Sharif-University-ESRLab/project-team-5/Code/ReadMe

This folder should contain the source code of your project.
