Sharif-University-ESRLab/project-team-5/Document/Final Report/latex/reportWeek3.tex

\documentclass[12pt,a4paper]{article}
\newcommand\persiangloss[2]{#1\dotfill\lr{#2}\\}
\usepackage{graphicx}
\usepackage{xcolor}
\usepackage{listings}
\usepackage{indentfirst}
\usepackage{float}
\usepackage[pagebackref=false,colorlinks,linkcolor=blue,citecolor=magenta]{hyperref}
\usepackage{xepersian}
\settextfont{XB Niloofar}
\definecolor{vgreen}{RGB}{104,180,104}
\definecolor{vblue}{RGB}{49,49,255}
\definecolor{vorange}{RGB}{255,143,102}

\lstdefinestyle{verilog-style}
{
	language=C,
	basicstyle=\small\ttfamily,
	keywordstyle=\color{vblue},
	identifierstyle=\color{black},
	commentstyle=\color{vgreen},
	numbers=left,
	numberstyle=\tiny\color{black},
	numbersep=10pt,
	tabsize=8,
	moredelim=*[s][\colorIndex]{[}{]},
	literate=*{:}{:}1
} 

\begin{document}
	\thispagestyle{empty}
	\vspace*{0mm}
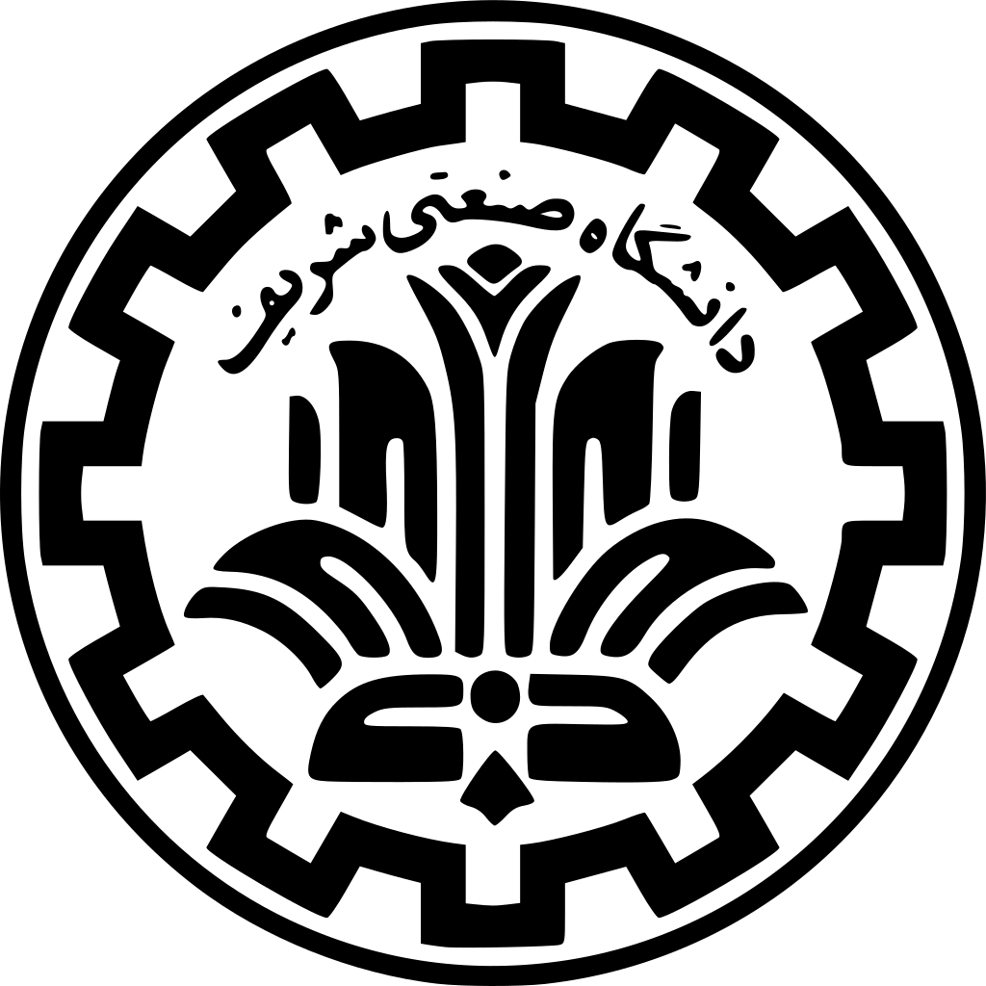
[picture p1: Document/Final Report/latex/logo.png]
	\centerline{}
	\vspace*{5mm}
	\begin{center}
		{\Huge
			لوستر هوشمند
		}
		\\[1cm]
		آزمایشگاه سخت‌افزار
		\\[1cm]
		دانشکده مهندسی کامپیوتر
		\\[4cm]
		{\large
			محمدرضا عبدی ۹۷۱۱۰۲۸۵
			
			حمیدرضا کامکاری ۹۷۱۱۰۱۷۷
			
			یگانه قره‌داغی 97106216
		}
		\\[5cm]
		خرداد ۱۴۰۱
	\end{center}
	\newpage
		\section*{چکیده}
	
	روند خودکار سازی فعلی خانه‌ها قدمی مهم برای کاهش مصرف بی‌اندازه برق و تسهیل زندگی افراد خانه است. انواع لوستر‌ها و تجهیزات روشنایی از جدیدترین وسایل اضافه شده به لوازم خانگی هوشمند هستند. هدف از این پروژه طراحی یک لوستر هوشمند است که بتواند به کمک یک برنامه به لوازم جانبی هوشمند دیگر (مانند تلفن‌های همراه) متصل شود و توسط آن به صورت خودکار یا دستی تنظیم شود. این دستگاه جزو یک شبکه اینترنت اشیا (\lr{Internet of Things}) است و با استفاده از یک برنامه موبایل قابل مدیریت است. 
	
	در این گزارش به توضیح قابلیت‌ها، محدودیت‌ها، قطعات و جزئیات پیاده‌سازی لوستر هوشمند در ۶ بخش می‌پردازیم.
	\newpage
	
	\tableofcontents
	
		\newpage
	
	\section{قابلیت‌های لوستر هوشمند}
	با توجه به اهداف پروژه در خودکار سازی روشنایی خانه\footnote{کاهش مصرف برق و تسهیل استفاده نسبت به لوسترهای مرسوم}، قابلیت‌های زیر برای محصول در نظر گرفته شده‌اند\footnote{جزئیات قابلیت‌ها در توصیف برنامه موبایل به صورت کامل توضیح داده‌ می‌شود.}:
	
	\begin{itemize}
		\item
		در اولین مرحله این لوستر می‌تواند به کمک سنسوری بر اساس شرایط محیطی مانند وضعیت پرده‌ها یا روشنایی طبیعی بازخورد بدهد؛ در صورت زیاد بودن شدت نور محیط، روشنایی لوستر کاهش و در صورت کم بودن شدت نور افزایش می‌یابد. میزان حساسیت نسبت به روشنایی و میزان روشنایی مورد نیاز می‌تواند بر اساس نیاز کاربر تغییر کند. به عنوان مثال پارامتر‌ اندازه اتاق می‌تواند در تنظیمات تاثیر داده شود. یعنی برای اتاق‌های بزرگتر شدت نور به هنگام روشن بودن بیشتر باشد. 
		\item
		می‌توان تنظیمات روشنایی لوستر را به صورت خودکار یا دستی تنظیم کرد. در صورت انتخاب حالت دستی، کاربر می‌تواند میزان روشنایی ثابتی را انتخاب کند.
		\item
		کاربر می‌تواند شاخه (اتاق‌های مختلف خانه) دلخواه خود را انتخاب کند و تنظیمات هر کدام از قسمت‌ها را به صورت جداگانه انجام دهد.
		\item
		کاربر می‌تواند از میان حالت‌های‌ \footnote{Mode} مختلف ارائه شده برای زیبایی یا رقص نور استفاده نماید.
		\item
		تمامی تنظیمات مذکور می‌توانند توسط یه برنامه موبایل سازگار با دستگاه‌های مبتنی بر سیستم‌عامل‌های مختلف همانند \lr{Andriod} و \lr{IOS} در لوستر اعمال شوند.
	\end{itemize}
	\newpage
	\section{محدودیت‌های اولیه لوستر هوشمند}
	
	در هنگام پیاده‌سازی و استفاده از پروژه با محدودیت‌هایی مواجه می‌شویم که در ادامه آن‌ها را تشریح می‌کنیم:
	
	\begin{itemize}
		\item
		چالش اصلی اتصال تعداد زیادی دیود ساطع نور \lr{LED\footnote{\lr{Light-emitting diode}}} با نورهای متغیر به برد برای شبیه‌سازی یک لوستر واقعی است. در نهایت با اتصال ۴۰ قطعه \lr{LED} به یک منبع خارجی ۵ ولت و کنترل آن بویسله خروجی \lr{PWM} و دو ترانزیستور (برای دو شاخه - کد این پروژه قابلیت پشتیانی از تعداد شاخه‌های بیشتر را نیز دارد) لوستر را شبیه‌سازی کردیم.
		\item
		در برخی موارد، برنامه‌های گوشی‌های هوشمند با اتصال خود به سیستم روشنایی سازگار نیستند. در این پروژه سعی شده‌است که یک برنامه موبایل سازگار با سیستم‌عامل‌های مانند \lr{Android}و \lr{IOS} مختلف برای برطرف شدن این مشکل ارائه شود.
		\item
		با وجود اینکه این موضوع کمتر و کمتر اتفاق می‌افتد، اما هر اتصال \lr{WiFi}‌ای گاهی اوقات دچار اختلال می‌شود. با توجه به اینکه لوستر هوشمند بستری بر پایه \lr{IoT} است، بدون اتصال \lr{WiFi} نمی‌توان از تنظیمات لوستر بهره برد. بنابراین پیشنهاد می‌شود که دکمه‌ها و یا کلید‌های سخت‌افزاری همچنان برای تنظیمات پایه‌ موجود باشد.
	\end{itemize}
	\newpage
	\section{قطعات مورد استفاده}
	لوستر از دو شاخه \lr{LED} تشکیل شده و میزان ولتاژ ورودی هر کدام از این شاخه‌ها از طریق پورت مربوطه روی بورد \lr{Arduino} و ترانزیستور (\lr{MOSFET IRF640}) کنترل می‌شود. برای پیاده‌سازی منطق لوستر از بورد \lr{Arduino Mega} استفاده می‌کنیم که از طریق سنسور‌های تشخیص نور (\lr{BH1750FVI}) نور محیط را تشخیص می‌دهد و بر اساس پیش‌فرض‌هاییکه در سرور \lr{IOT} چیده‌شده میزان ولتاژ خروجی‌های آنالوگ را تنظیم می‌کند. از طرفی برای اتصال به اینترنت اشیا یک سرور کوچک خانگی را روی ماژول \lr{ESP8266 ESP-01S} اجرا می‌کنیم. این سرور تنظیمات کنترل لوستر را در خود دارد و با استفاده از گوشی همراه و اتصال به آن سرور می‌توانیم این تنظیمات را کنترل کنیم. می‌توان در این پروژه از برد \lr{Arduino Uno} نیز استفاده کرد.
	
	در جدول زیر می‌توان هزینه برآورد شده قطعات و هزینه‌های پروژه را مشاهده کرد (هزینه کل معادل با 7,580,000 ریال است).
	
	\begin{table}[H]
		\centering
		\begin{tabular}{|c|c|c|}
			\hline
			هزینه     & تعداد & نام قطعه                                    \\ \hline
			700,000   & ۱     & ماژول سنجش شدت نور GY-30 با سنسور BH1750FVI \\ \hline
			۴۵۰,۰۰۰   & ۱     & ماژول ESP8266وای فای                        \\ \hline
			4,500,000 & 1     & آردوینو مگا 2560 R3                         \\ \hline
			200,000   & 1     & کابل USB به USB Type-B مخصوص آردوینو        \\ \hline
			240,000   & ۴۰    & اورل LED در دو رنگ اصلی                     \\ \hline
			70,000    & ۱     & کابل 30 سانتی نر به ماده (1  بسته 40 عددی)  \\ \hline
			700,000   & ۲     & کابل جامپر مخصوص برد بورد (بسته ۶۰ عددی)    \\ \hline
			700,000   & ۲     & برد بورد مدل MB-102 بدون ماژول تغذیه        \\ \hline
			20,000    & ۱۰    & مقاومت                                      \\ \hline
		\end{tabular}
		\caption{برآورد هزینه قطعات}
	\end{table}
	
	لیست قطعات و شرح پین‌های آن‌ها به شرح زیر است:
	\begin{enumerate}
		\item {
			سنسور روشنایی : \lr{BH1750FVI}
			\footnote{	ما مقادیر \lr{lux} را از \lr{BH1750} از طریق باس \lr{I2C} دریافت می کنیم. \lr{ADC} در \lr{IC} روشنایی آنالوگ را به مقدار لوکس دیجیتال تبدیل می‌کند. سپس این داده‌ها با کمک پین‌های \lr{I2C} یعنی \lr{SCL} و \lr{SDA} به میکروکنترلر منتقل می‌شوند. \lr{SCL} برای ارائه پالس ساعت و \lr{SDA} برای انتقال مقدار \lr{lux} استفاده می‌شود.}}
		
		\begin{figure}[H]
			\centering
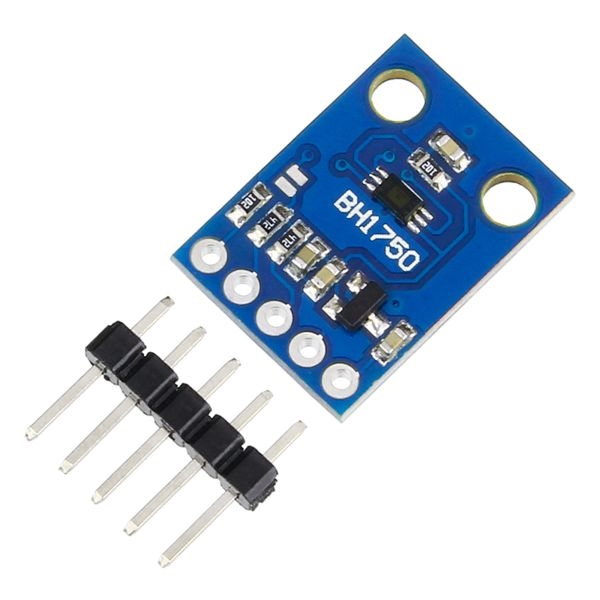
[picture p2: Document/Final Report/latex/figs/BH1750FVI.jpeg]
			
			\caption{
				سنسور روشنایی \lr{BH1750FVI}
			}
			\label{fig:schema1}
		\end{figure}
		
		\begin{figure}[H]
			\centering
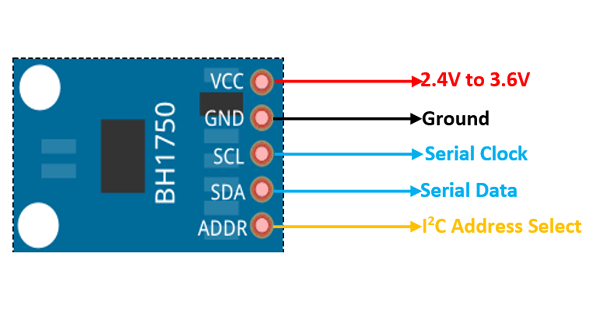
[picture p3: Document/Final Report/latex/figs/BH1750-Light-Sensor-Pinout.png]
			
			\caption{
				شرح پین‌های \lr{BH1750FVI}
			}
			\label{fig:schema2}
		\end{figure}
		
		\begin{figure}[H]
			\centering
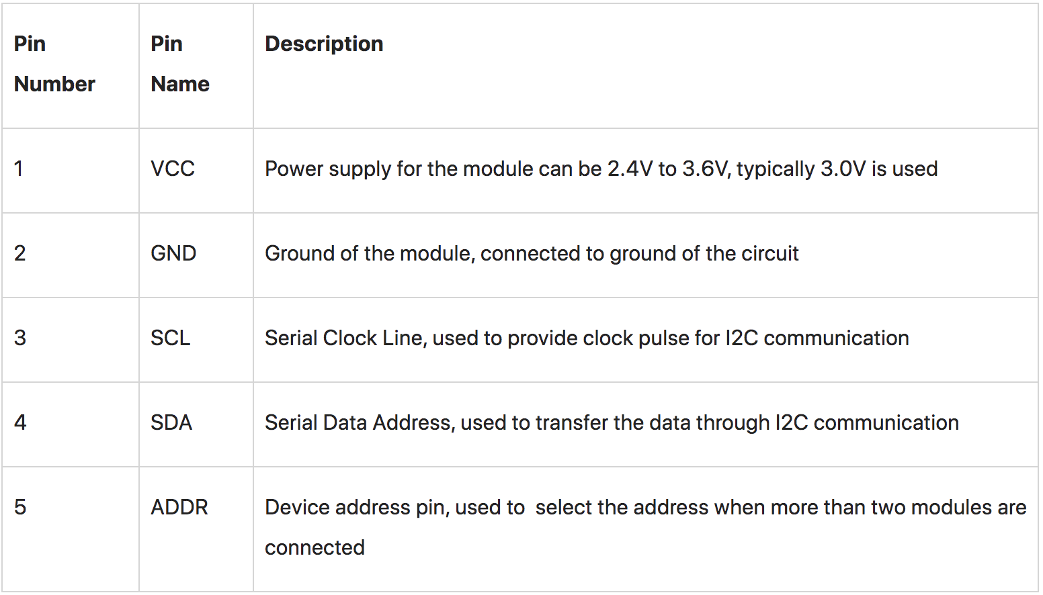
[picture p4: Document/Final Report/latex/figs/BH1750FVI-pin-config.png]
			
			\caption{
				تنظیمات پین‌های \lr{BH1750FVI}
			}
			\label{fig:schema3}
		\end{figure}	
		
		\item {
			برد آردویینو مگا : \lr{Arduino Mega 2560 R3}
		}
		
		\begin{figure}[H]
			\centering
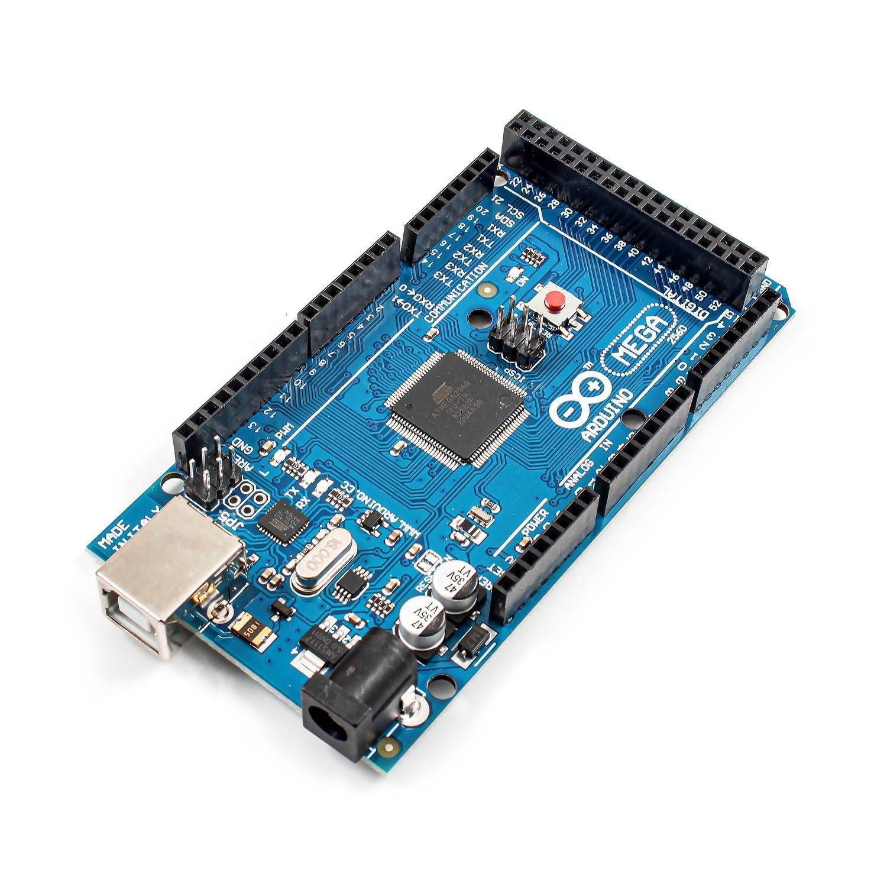
[picture p5: Document/Final Report/latex/figs/ard-mega.jpeg]
			
			\caption{
				برد \lr{Arduino Mega 2560 R3}
			}
			\label{fig:schema4}
		\end{figure}
		
		\begin{figure}[H]
			\centering
			
			\caption{
				شرح پین‌های \lr{Arduino Mega 2560 R3}
			}
			\label{fig:schema5}
		\end{figure}
		
		\item {
			ماژول وای‌فای : \lr{ESP8266 ESP-01S}
			\footnote{
					این ماژول می‌تواند هم به عنوان یک نقطه دسترسی و هم به عنوان یک ایستگاه متصل به وای‌فای کار کند، بنابراین به راحتی داده‌ها را واکشی کرده و در اینترنت آپلود کند. همچنین می‌تواند با استفاده از \lr{API}، داده‌ها را از اینترنت واکشی کند و به هر اطلاعاتی که در اینترنت موجود است دسترسی داشته باشد. این ماژول فقط با ولتاژ 3.3 ولت کار می‌کند و هر ولتاژی بیش از 3.7 ولت باعث از بین رفتن ماژول می‌شود.
			}
		}
		
		\begin{figure}[H]
			\centering
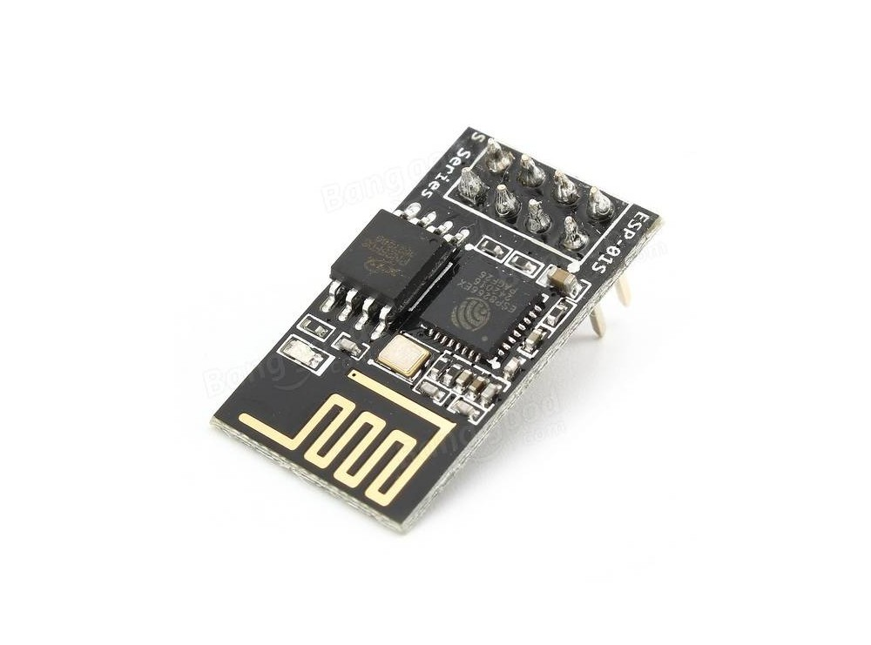
[picture p7: Document/Final Report/latex/figs/esp8266-esp-01s.jpeg]
			
			\caption{
				ماژول وای‌فای \lr{ESP8266 ESP-01S}
			}
			\label{fig:schema7}
		\end{figure}
		
		\begin{figure}[H]
			\centering
			
			\caption{
				شرح پین‌های \lr{ESP8266 ESP-01S}
			}
			\label{fig:schema8}
		\end{figure}
		
		\begin{figure}[H]
			\centering
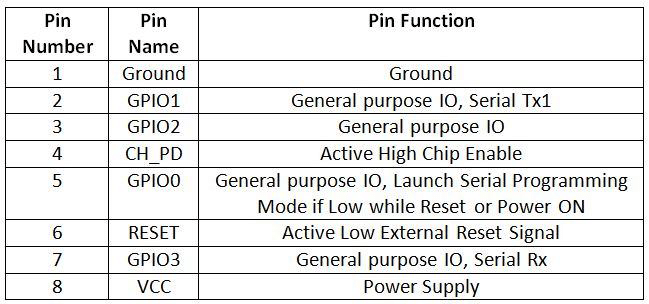
[picture p9: Document/Final Report/latex/figs/ESP-01-pin-configuration-The-RESET-and-VCC-pins-of-the-module-are-connected-to-the-33-V.png]
			
			\caption{
				تنظیمات پین‌های \lr{ESP8266 ESP-01S} (در اینجا پین \lr{GPIO1} همان \lr{TX} و \lr{GPIO3} همان \lr{TX} است. همچنین \lr{CH\_PD} معادل \lr{CH\_EN} در شرح پین است. )
			}
			\label{fig:schema9}
		\end{figure}	
		
		\item {
			ترانزیستور : \lr{MOSFET IRF640}
			\footnote{
				
					ماژول \lr{IRF640} یک ماسفت با $N$ کانال است که برای اهداف سوئیچینگ با سرعت بالا طراحی شده است. این قابلیت سوئیچینگ با سرعت بالا می تواند در برنامه هایی که سرعت سوئیچینگ در آنها بسیار مهم است بسیار مفید باشد. در لوستر هوشمند، روشنایی \lr{LED} ها به سرعت توسط \lr{PWM} تغییر کند. در اینجا با توجه به اینکه منبع ولتاژ خارجی است (باتری)، باید از یک ماسفت استفاده کنیم.
				}}
		
		\begin{figure}[H]
			\centering
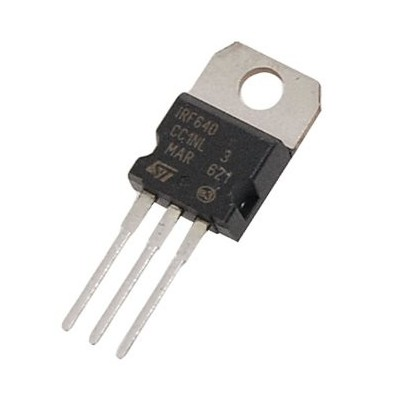
[picture p10: Document/Final Report/latex/figs/irf640.jpeg]
			
			\caption{
				ترانزیستور \lr{MOSFET IRF640}
			}
			\label{fig:schema10}
		\end{figure}
		
		\begin{figure}[H]
			\centering
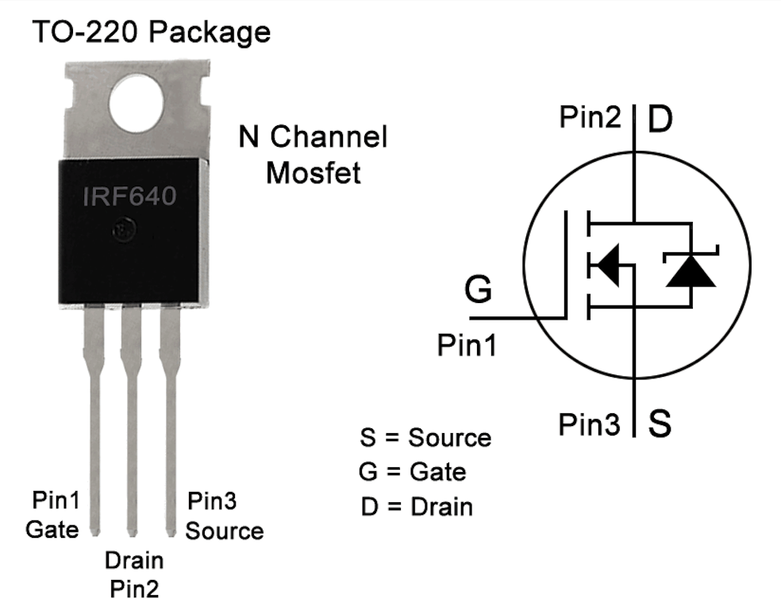
[picture p11: Document/Final Report/latex/figs/irf-pinout.png]
			
			\caption{
				ترانزیستور \lr{MOSFET IRF640}
			}
			\label{fig:schema11}
		\end{figure}
			
	\end{enumerate}
	
	\newpage
	\section{طراحی مدار}
	مدار نهایی لوستر هوشمند در طی سه مرحله طراحی شده‌است. در مرحله اول مدار سنسور روشنایی بسته شد تا بتوانیم روشنایی تعداد کمی \lr{LED} را تحت تاثیر نور محیط تغییر دهیم. در مرحله دوم دو شاخه ۲۰ تایی از \lr{LED} ها را متصل کرده و به کمک منبع خارجی روشن می‌کنیم. در آخرین مرحله ماژول وای‌فای را برای برقراری ارتباط میان برنامه موبایل و آردویینو وصل می‌کنیم. هر کدام از مراحل به تفصیل در ادامه این بخش تشریح می‌شوند.
	
	\begin{enumerate}
\item اتصال سنسور روشنایی:
در این مرحله ماژول 
\lr{BH1750}
برای تشخیص نور را بورد آردویینو طبق شکل زیر وصل می‌کنیم. همانطور که مشاهده می‌شود، پورت‌های
\lr{SCL}
و
\lr{SDA}
به پورت مربوطه با همان اسم در آردویینو متصل شده‌اند. 
\lr{VCC}
را به ۵ ولت و 
\lr{ADO}
و
\lr{GND}
را به زمین متصل کردیم.
 \begin{figure}[H]
	\centering
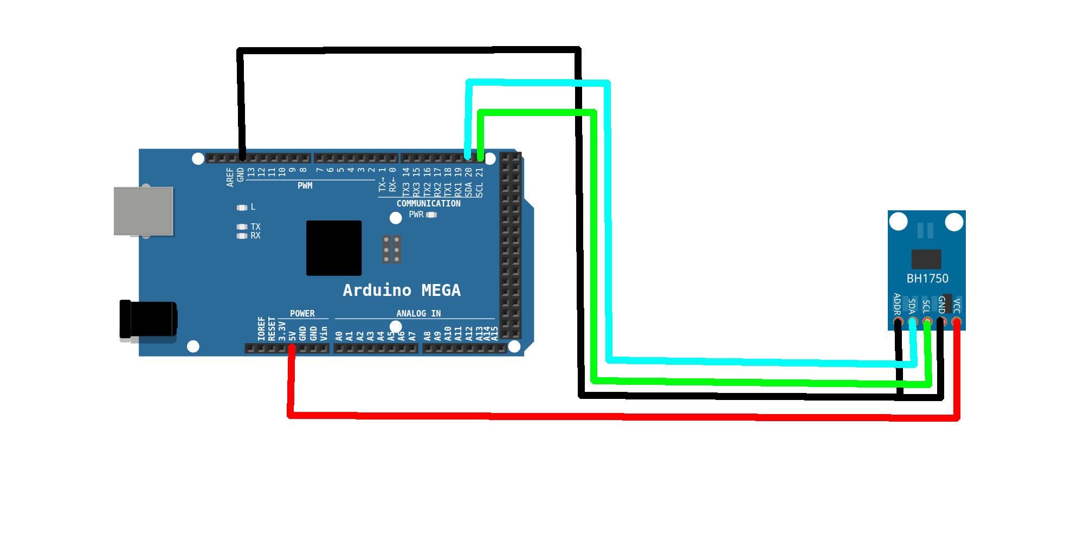
[picture p12: Document/Final Report/latex/figs/schema.jpg]
	
	\caption{
		شماتیک مدار تشخیص نور.
	}
	\label{madar}
\end{figure}

با استفاده از رابطه‌ای ساده ورودی به‌دست آمده از سنسور را با فرمولی تبدیل به 
\lr{Brightness}
ای می‌کنیم که از طریق 
\lr{PWM}
قابل کنترل است. مقدار ورودی سنسور را می‌توان با عددی ممیز شناور در بازه $0$ تا 
$2^{16}$
مدل کرد. اما به علت کاربرد ما که نور محیطی است، این مقدار خروجی با استفاده از آزمایش مقداری بین $0$ و 
$500$
به دست آمد. پس از 
\lr{scale}
کردن این مقدار بین صفر و یک مقدار روشنایی خروجی را به صورت عددی اعشاری به دست آوردیم که پس از ضرب شدن در 
$255$
به ما عدد روشنایی 
\lr{LED}
ها را می‌دهد. 

\item 
اتصال ۴۰ \lr{LED} برای شبیه‌سازی عملکرد لوستر:
هدف از این آزمایش این مرحله، بستن یک لوستر شامل ۴۰ قطعه \lr{LED}، اتصال آن به منبع خارجی، همچنین کنترل آن با ترانزیستور و در نهایت تقسیم ۴۰ \lr{LED} به دو شاخه مستقل از هم است.

ابتدا، مدار آردویینو شامل سنسور مرحله قبل را بر اساس شماتیک زیر تکمیل می‌کنیم. از ترانزیستور \lr{MOSFET IRF640} برای کنترل و یک باتری ۵ ولتی به عنوان منبع خارجی استفاده می‌کنیم.

\begin{figure}[H]
	\centering
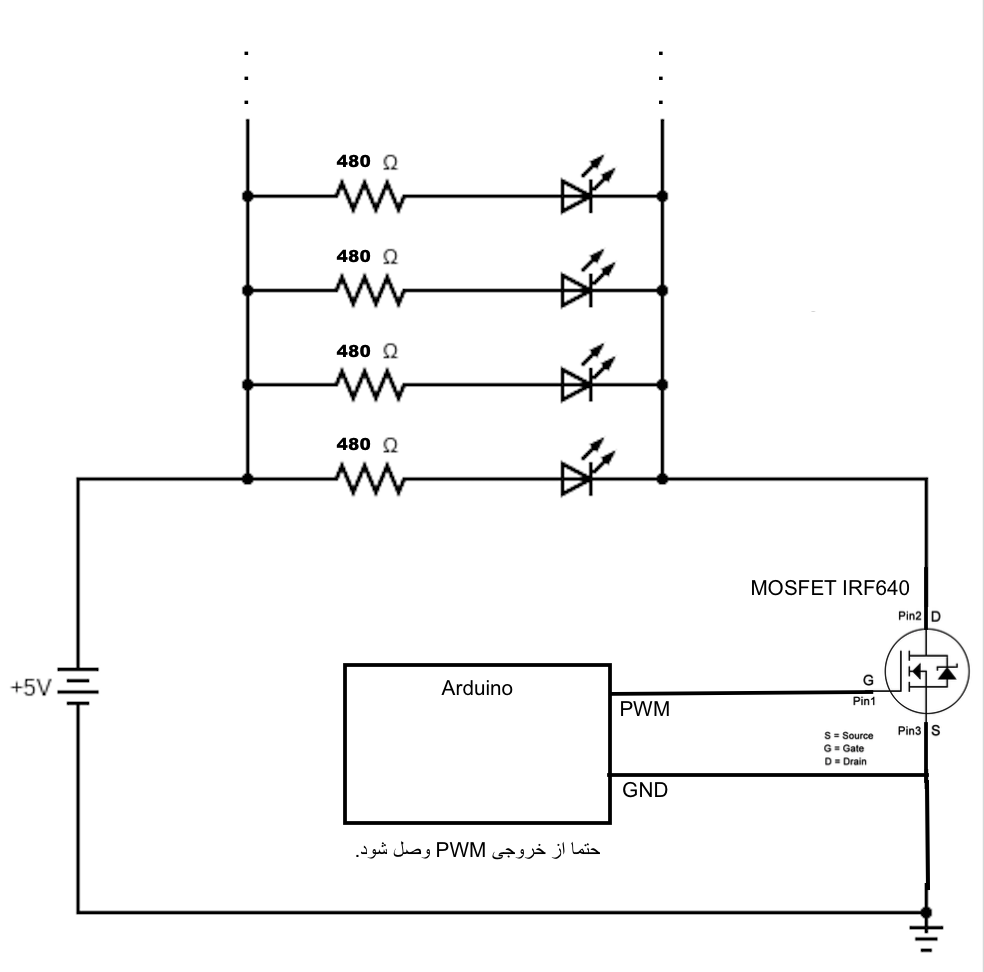
[picture p13: Document/Final Report/latex/figs/schematics.png]
	
	\caption{
		شماتیک مدار اتصال ۲۰ \lr{LED} موجود در یک شاخه. هرکدام از شاخه به یکی از پین‌های \lr{PWM} شماره ۶ یا ۷ آردویینو متصل می‌شوند.
	}
	\label{fig:schema12}
\end{figure}

در این مدار، \lr{LED} ها به باتری وصل هستند و خروجی \lr{PWM} به گیت کنترل ترانزیستور \lr{MOSFET IRF640} متصل است. می‌دانیم که \lr{PWM} به کمک روشن و خاموش کردن سریع می‌تواند روشنایی را کنترل کند. در اینجا، بجای اتصال مستقیم \lr{PWM} به \lr{LED} ها، به گیت ترانزیستور متصل شده و آن را به سرعت قطع و وصل می‌کند. یعنی ترانزیستوری میان باتری و \lr{LED} است که سرعت قطع و وصل کردن آن با \lr{PWM} تنظیم می‌شود.
\item اتصال ماژول وای‌فای: 
	برای ارتباط میان موبایل اپ و آردوییو به کمک ماژول وای‌فای \lr{ESP8266 ESP-01S}، مدار را در مراحل زیر تکمیل می‌کنیم (دقت کنید که هنگام آپلود کردن کد باید پین‌های \lr{RX} و \lr{TX} قطع شوند):
	\begin{enumerate}
		\item
		پین \lr{RX} در ماژول \lr{ESP} را به پین \lr{TX} آردویینو متصل می‌کنیم.
		\item
		پین \lr{TX} در ماژول \lr{ESP} را به پین \lr{RX} آردویینو متصل می‌کنیم.
		\item
		پین \lr{CH\_PD} یا \lr{Enable} در ماژول \lr{ESP} را به پین \lr{+3V} آردویینو متصل می‌کنیم.
		\item
		پین \lr{VCC} در ماژول \lr{ESP} را به پین \lr{+3V} آردویینو متصل می‌کنیم.
	\end{enumerate}
		\end{enumerate}
	در نهایت می‌توان مدار کلی را در شکل زیر مشاهده کرد:
		 \begin{figure}[H]
		\centering
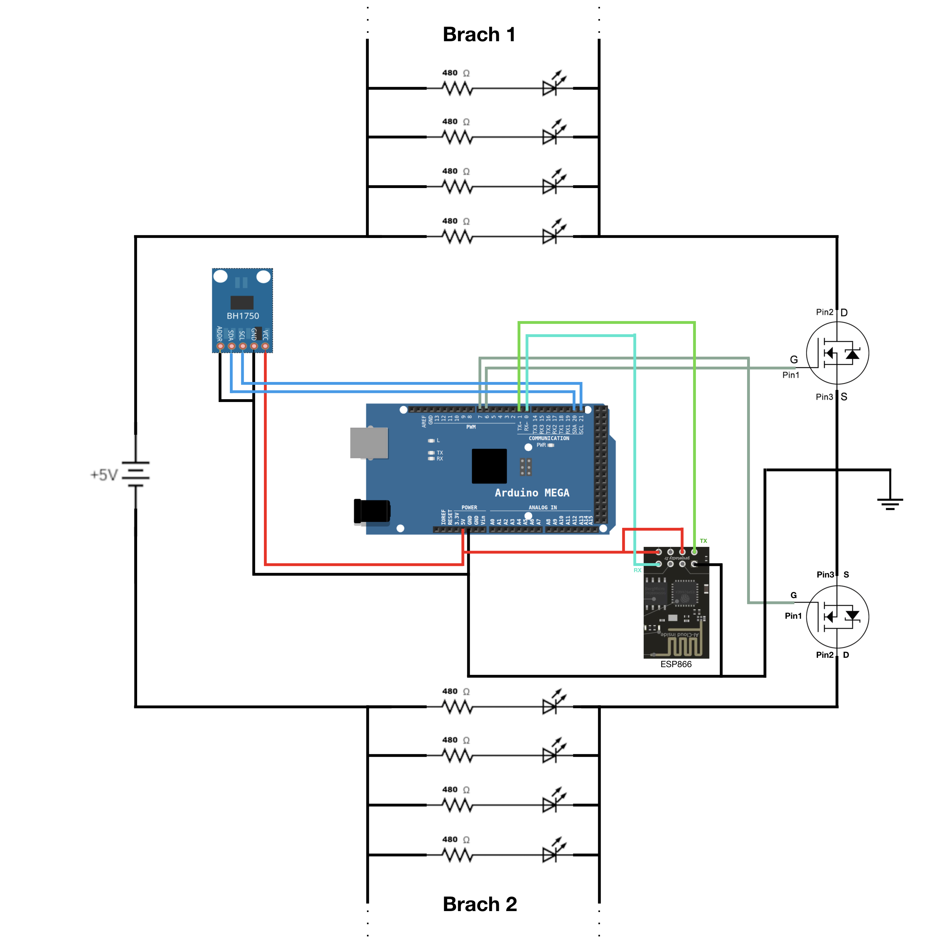
[picture p14: Document/Final Report/latex/figs/finalcircuit001.jpeg]
		
		\caption{
			مدار نهایی
		}
		\label{fig:schema1}
	\end{figure}
		\newpage
	\section{\lr{RemoteXY}}
	 \lr{RemoteXY}
	 یک ابزار کنترلی برای کنترل مدارها با برد های اصلی آردوینو از طریق موبایل با کامپیوتر می‌باشد. به طور خلاصه در این ابزار ابتدا یک رابط کاربری به صورت گرافیکی طراحی می‌شود، سپس تعیین می‌گردد که این رابط برای چه کنترل چه بردی طراحی شده و با چه ماژولی به برد متصل می‌گردد. (از طریق ماژول های بلوتوث، وای‌فای یا \lr{OTG}) در ادامه پارامتر‌های کلی مدار شامل نحوه اتصال ماژول ارتباطی به برد، سرعت پورت‌های سریال، نام کاربری و پسورد مربوط به نقطه اتصال وای‌فای و… تعیین می‌شوند. در نهایت این ابزار یک فایل \lr{ project.ino } به ما می‌دهد که حاوی \lr{strcut} \lr{RemoteXY} و پارامتر‌های مورد نیاز می‌باشد. سپس برنامه‌ی اصلی در توابع loop و setup نوشته می‌شود که توضیحات آن در بخش توضیحات کد قابل مشاهده است. دقت کنید که قبل از کامپایل کردن کد در \lr{Arduino IDE} ابتدا می‌بایست کتابخانه \lr{RemoteXY Library} را از  
	 \href{https://remotexy.com/en/library/}{این لینک}
	 دانلود کرده و به \lr{IDE} اضافه کنیم.
	 \begin{figure}[H]
	 	\centering
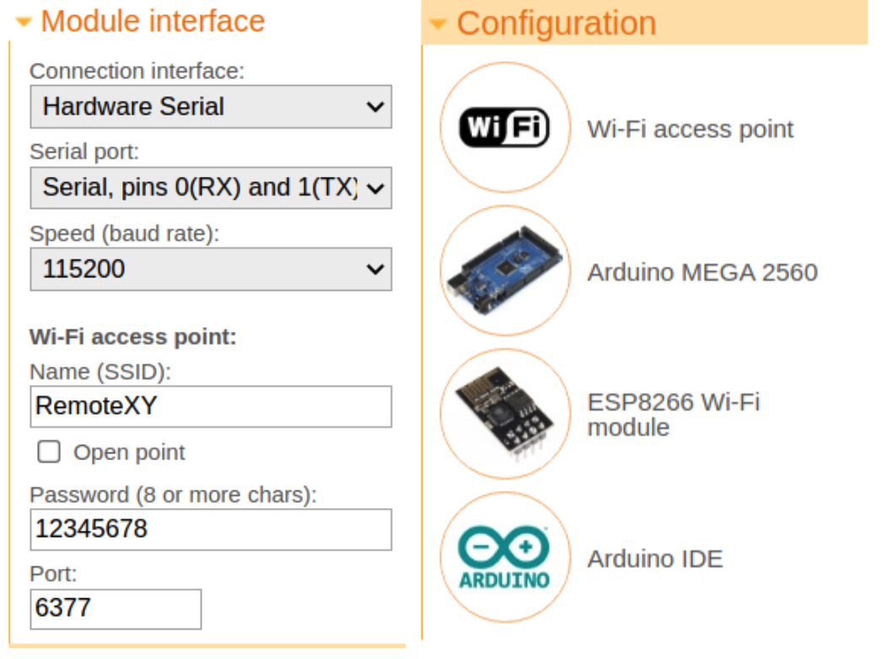
[picture p15: Document/Final Report/latex/figs/initial-conf.png]
	 	
	 	\caption{
	 	تصاویر مربوط به تنظیمات اولیه
	 	}
	 	\label{fig:schema1}
	 \end{figure}
 
 	 \begin{figure}[H]
 	\centering
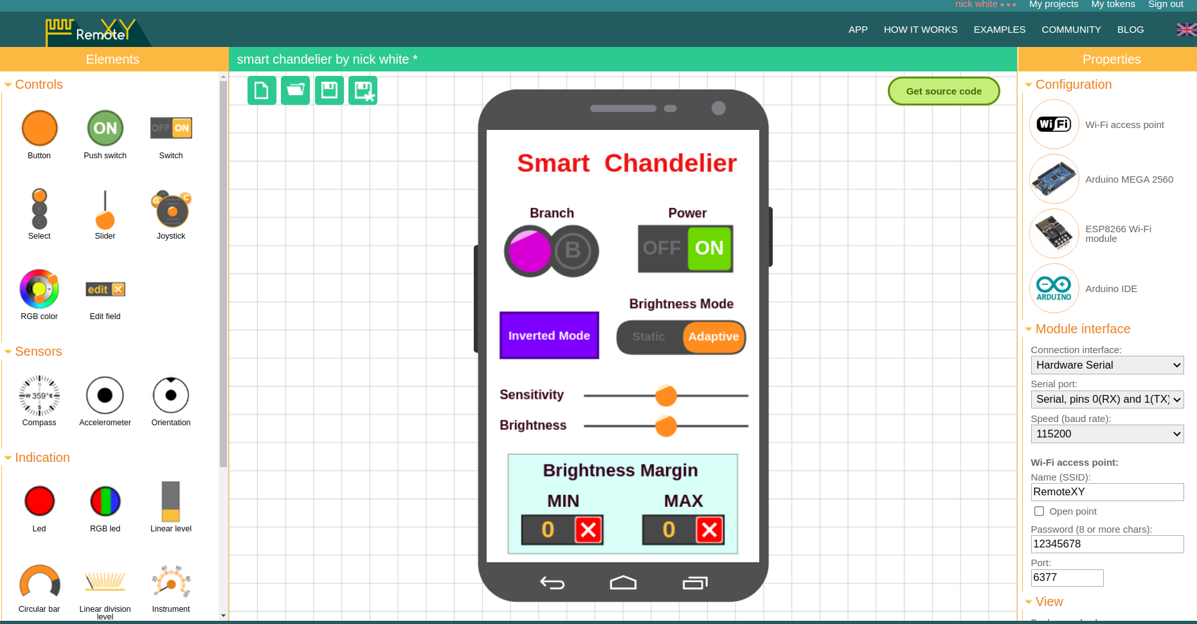
[picture p16: Document/Final Report/latex/figs/initial-conf-nama.png]
 	
 	\caption{
 		نمای کلی از محیط طراحی رابط کاربری در برنامه تحت وب \lr{RemoteXY}
 	}
 	\label{fig:schema1}
 \end{figure}

برای اجرای مدار:
\begin {enumerate}
\item
دو شاخه \lr{LED} و برد آردوینو را به برق متصل می‌کنیم.
\item
اپلیکیشن موبایل \lr{RemoteXY} را دانلود کرده و نصب می‌کنیم. سپس از منوی سمت چپ گزینه  \lr{WiFi point} را انتخاب کرده و نقطه  \lr{ smart\_chandelier} را انتخاب می‌کنیم. (دقت کنید که پورت اتصال روی 6377 تنظیم شده باشد.)
\item
سپس کلمه عبور 12345678 را وارد کرده تا اتصال از طریق ماژول وای‌فای برقرار گردد.
 	 \begin{figure}[H]
	\centering
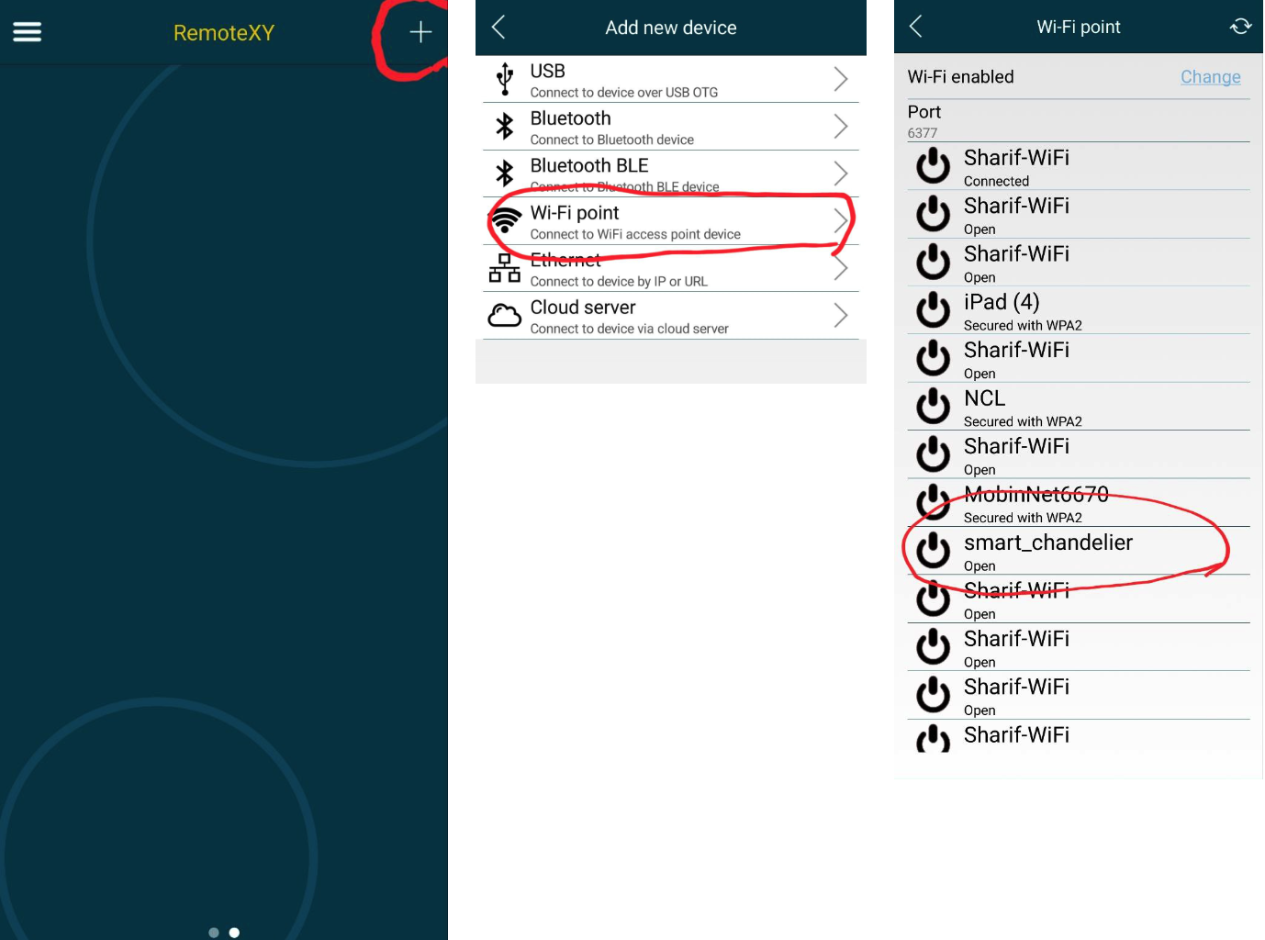
[picture p17: Document/Final Report/latex/figs/item3.png]
	
	\caption{
		نمای کلی از محیط طراحی رابط کاربری در برنامه تحت وب \lr{RemoteXY}
	}
	\label{fig:schema1}
\end{figure}
\item
بعد از اتصال به مدار، رابط کاربری طراحی شده پدیدار می‌گردد و می‌توان روشنایی شاخه‌ها را با آن کنترل کرد.

\end {enumerate}

	\newpage
\section{برنامه موبایل}
متناسب به قابلیت‌های لوستر، یک برنامه موبایل طراحی کرده‌ایم که بتوان در آن تنظیمات نام‌برده مربوط به لوستر هوشمند را انجام داد. شماتیک برنامه به شکل زیر است:

	\begin{figure}[H]
	\centering
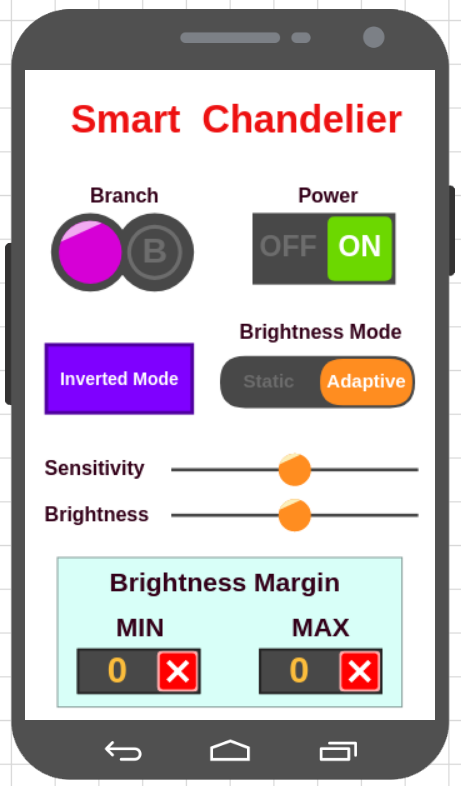
[picture p18: Document/Final Report/latex/figs/shcema-ma.png]
	
	\caption{
		شماتیک اپلیکیشن موبایل
	}
	\label{fig:schema13}
\end{figure}
در نهایت می‌توان با نصب کردن برنامه موبایل و اتصال آن به \lr{ESP} و آردویینو، تنظیمات موردنظر را انجام داد. این تنظیمات و گزینه‌های موجود در این موبایل اپ به شرح زیر است:
	\begin{itemize}
		\item 
		{تنظیم حساسیت سنسور نوری:} کاربر می‌تواند با انتخاب عددی میان ۱۰ الی ۱۵۰ (توسط \lr{slidebar})، میزان حساسیت سنسور نور را تنظیم کند (عدد کمتر معادل حساسیت کمتر است؛ یعنی میزان نور با تغییرات بیشتری نسبت به عددی بیشتر تغییر می‌کند).
		\item 
		{دکمه روشن و خاموش:} کاربر می‌تواند تمامی چراغ‌های لوستر (شاخه مورد نظر) را خاموش یا روشن کند.
		\item 
		{انتخاب شاخه:} کاربر می‌تواند انتخاب کند که متغیرهای تغییر داده شده، مربوط به کدام شاخه باشند (هر شاخه، مستقل از شاخه دیگر حالت‌های مختلف و دکمه‌های متفاوت دارد).
		\item 
		{حالت استاتیک یا داینامیک (\lr{Adaptive}):} کاربر می‌تواند با حالت استاتیک یک مقدار خاص را برای روشنایی انتخاب کرده و تمامی \lr{LED} های لوستر با آن مقدار تنظیم می‌شوند. در حالت داینامیک نیز مقدار روشنایی لوستر با سنسورهای تنظیم می‌شود.
		\item 
		{تنظیم حداکثر و حداقل میزان روشنایی:} کاربر می‌تواند با انتخاب عددی میان ۰ تا ۲۵۵(توسط \lr{slidebar})، حداقل و حداکثر میزان روشنایی یک شاخه را تعیین کند. بنابراین روشنایی یک شاخه، محدود به این دو عدد می‌شود و نمی‌تواند مقداری خارج از این بازه بگیرد.
		\item 
		{مودهای مختلف لوستر:} مودهای متفاوت که می‌توانند شامل لوستر را در حالت تنظیم داینامیک عادی یا رقص نور (همانند گزارش اول) تنظیم کنند (این حالت‌ها در قسمت‌های بعدی تکمیل می‌شوند). یکی از مودهای در نظر گرفته شده برای این قسمت حالت \lr{Inverted min to max} است که در آن نور دو شاخه به صورت معکوس با همدیگر کم و زیاد می‌شود.
		
	\end{itemize}
\newpage
	\section{توضیحات کد}
	
	\input{hamidrezacode}
	
	%\begin{latin}
	%	\lstinputlisting[style={verilog-style}]{src/project.ino}
	%\end{latin}

		\newpage
\section{راه اندازی پروژه}
\begin{enumerate}
	\item
	ابتدا در سایت \lr{remotexy} یک اکانت ساخته و به بخش\lr{ My Projects }رفته و یک پروژه جدید ایجاد کنید.
	\item
	مطابق موارد صحبت شده در بخش قبلی، پیکربندی مدار را انجام داده و رابط گرافیکی موبایل را طراحی کنید.
	\item
	روی گزینه \lr{Get Source Code} کلیک کرده تا فایل ino پروژه دریافت شود.
	\item
	در \lr{Arduino IDE} کتابخانه \lr{remotexy} را اضافه کنید (از طریق قرار دادن فایل‌های کتابخانه در پوشه \lr{libraries} نرم‌افزار).
	\item
	پروژه دریافت شده از سایت را با \lr{Arduino IDE} باز کرده و آن را به دلخواه تغییر دهید.
	\item
	مدار را مطابق جزئیات مطرح شده ببندید و برد آردوینو را با کابل \lr{USB} به سیستم خود متصل کنید
	\item
	قبل از کامپایل کردن کد، از بخش \lr{Tools} مقادیر \lr{processor} و \lr{board} را مطابق با مدل آردوینو خود تنظیم کنید (در اینجا \lr{Arduino Mega} و \lr{Mega 2560} می‌باشد).
	\item
	کد را کامپایل کرده و در بورد آپلود کنید.

\end{enumerate}
\textcolor{red}{توجه}: 
قبل از آپلود کردن کد روی برد آردوینو، حتما می‌بایست اتصال‌های \lr{TX} و \lr{RX} را بین آردوینو و ماژول وای‌فای \lr{ESP8266} قطع کنید. بعد از آپلود کد، یکی از \lr{LED} های آردوینو شروع به چشمک زدن می‌کند. سپس می‌بایست اتصال \lr{TX} و \lr{RX} دوباره برقرار شوند. دقت کنید که اگر قبل از آپلود کردن کد پایه های \lr{TX} و \lr{RX} متصل باشند، آردوینو نمی‌تواند با ماژول وای‌فای ارتباط برقرار کند.

\begin{itemize}
\item
‌ مراحل مذکور صرفا برای تغییر و به روز‌ رسانی کد پروژه و مدار بسته شده می‌باشد و در صورتی که بخواهیم صرفا، مدار را روشن کرده و خروجی را ببینیم، صرفا باید مدار روشن شود و نیازی به سپری کردن مراحل مذکور نخواهد بود.
\item
همچنین دقت کنید که بخش ایجاد و توسعه واسط کاربری مستقل از حساب کاربری ساخته شده در سایت می‌باشد، این بدین معنی است که برای اجرای مدار نیاز به ساخت و ورود در هیچ حساب کاربری‌ای نداریم و همچنان در کد ایجاد شده توسط ابزار \lr{RemoteXY}هیچ وابستگی‌ای به اطلاعات حساب کاربری‌ای که پروژه را ایجاد کرده مشاهده نمی‌شود.
\end{itemize}

	\newpage
\section*{بسته‌بندی‌}
از آنجایی که محصول یک لوستر می‌باشد، در سقف قرار گرفته و صرفا وجود یک قاب که از پنج وجه آن را بپوشاند کافی است. ابعاد جعبه، با توجه به در نظر گرفتن ابعاد برد آردوینو، \lr{breadboard}، ماژول وای‌فای و مخزن باتری
 $25\times22\times10$ 
 سانتی‌متر مکعب می‌باشد. همچنین سنسور نور در بیرون از لوستر قرار گرفته به طوری که در معرض نور مستقیم خورشید قرار گیرد. (بیرون از پنجره‌ها) طرح کلی جعبه از سه نما به صورت زیر می‌باشد:
 	\begin{figure}[H]
 	\centering
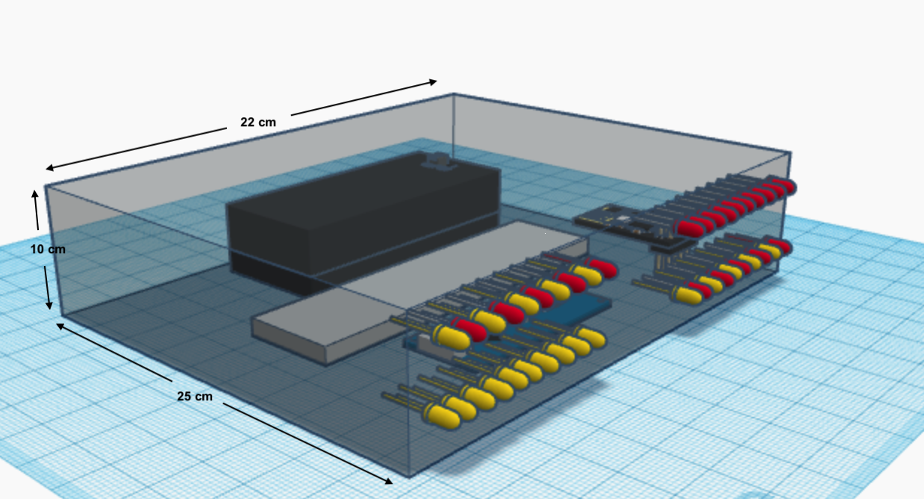
[picture p19: Document/Final Report/latex/figs/nama-roberoo.png]
 	
 	\caption{
 		نمای سه بعدی جعبه طراحی شده
 	}
 	\label{fig:schema13}
 	\end{figure}
 		\begin{figure}[H]
 		\centering
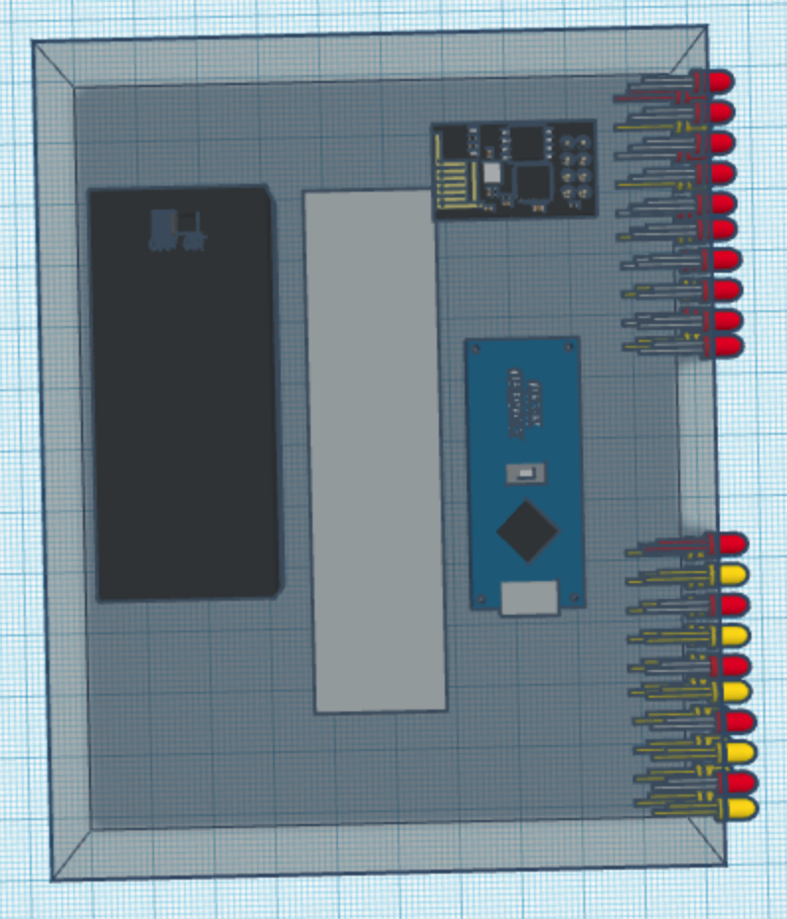
[picture p20: Document/Final Report/latex/figs/nama-bala.png]
 		
 		\caption{
 			نمای سه بعدی جعبه طراحی شده - از بالا
 		}
 		\label{fig:schema13}
 	\end{figure}
 			\begin{figure}[H]
 			\centering
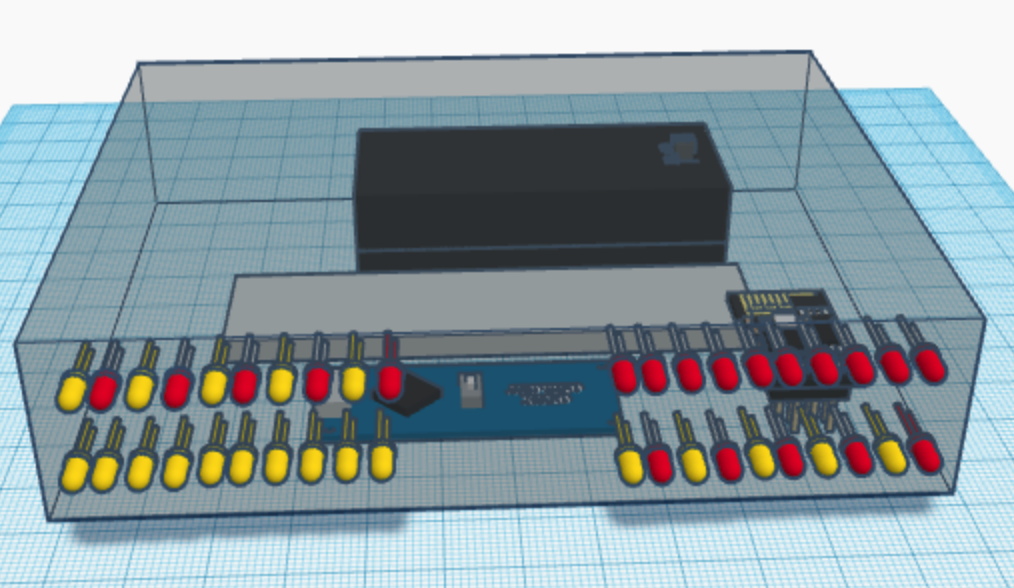
[picture p21: Document/Final Report/latex/figs/nama-jolo.png]
 			
 			\caption{
 				نمای سه بعدی جعبه طراحی شده - از روبرو
 			}
 			\label{fig:schema13}
 		\end{figure}

	\newpage
\section*{جمع‌بندی}
در این پروژه قصد داشتیم که یک  لوستر هوشمند طراحی کنیم که بتواند با توجه به نیازمندی‌های کاربر روشنایی دو اتاق در خانه را شبیه‌سازی کند. کاربر می‌تواند بوسیله برنامه موبایل و به طریق بی‌سیم از میان حالت‌های ارائه شده انتخاب کند یا تنظیمات خودش را اعمال نماید. برای ادامه دادن این کار می‌توان تنظیمات ساعت‌های روشنایی را طبق برنامه کاربر نیز به برنامه اضافه کرد.

مدار نهایی در شکل زیر قابل مشاهده است:

(\href{https://mega.nz/file/sV8AgRSR#gpizWW71jrvvycUeRTwPTCkDCR79WKKiugmJP3BU1oc}{لینک ویدیو عملکرد لوستر هوشمند})

\begin{figure}[H]
	\centering
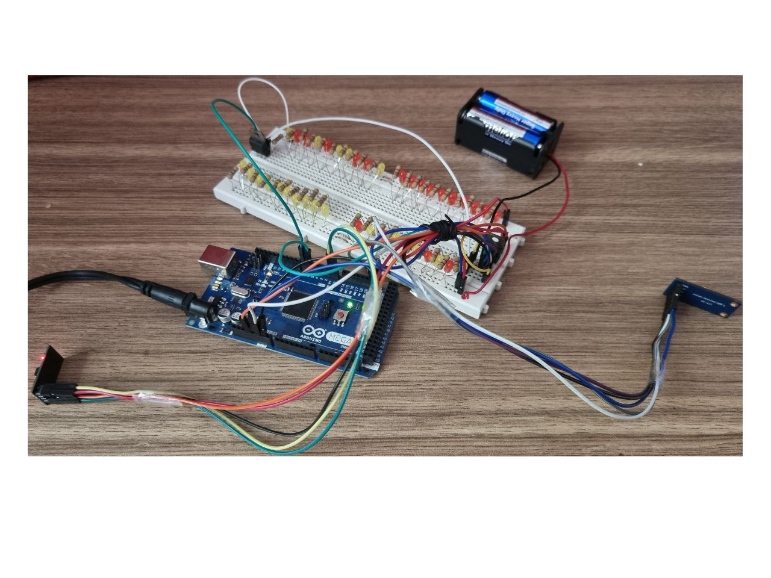
[picture p22: Document/Final Report/latex/figs/final.png]
	
	\caption{
		مدار نهایی لوستر هوشمند
	}
	\label{fig:schema14}
\end{figure}
\end{document}
