Sharif-University-ESRLab/project-team-5/Document/Week 3/Report-Group-5-3.pdf

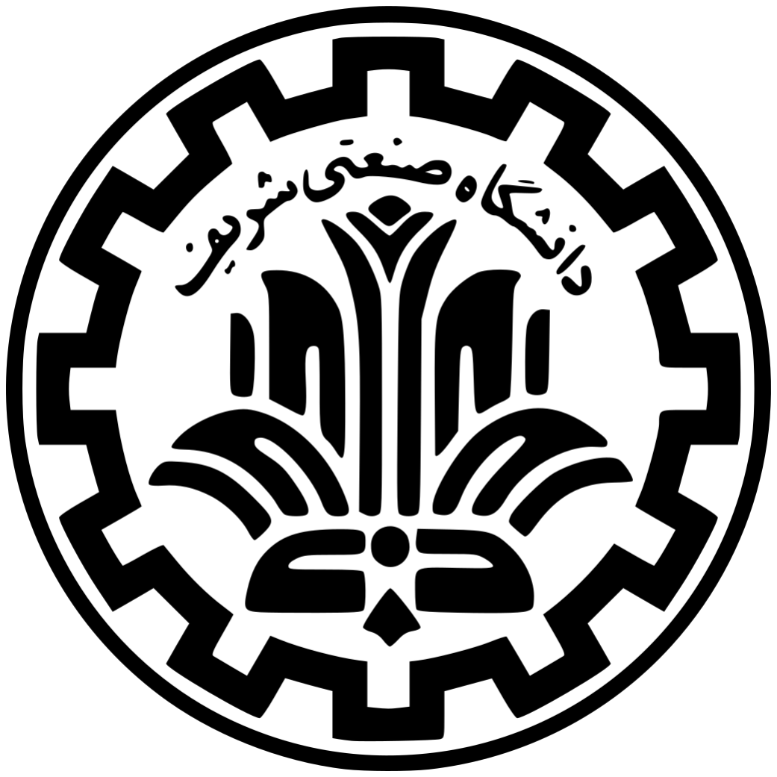
[picture p28: figure]

# لوستر هوشمند ⁃ گزارش سوم

آزمایشاه سخت افزار

دانشده مهندس کامپیوتر

### محمدرضا عبدی ۹۷۱۱۰۲۸۵ حمیدرضا کاماری ۹۷۱۱۰۱۷۷ یانه قره داغ ۹۷۱۰۶۲۱۶

اردیبهشت ۱۴۰۱

## گزارش سوم

هدف از این آزمایش این هفته، بستن ی لوستر شامل ۴۰ قطعه LED، اتصال آن به منبع خارج
و همچنین کنترل آن با ترانزیستور است. در مرحله اول، مدار آردویینو شامل سنسور هفته گذشته را بر اساس شماتی زیر تکمیل م کنیم.
از ترانزیستور 640IRF MOSFET برای کنترل و ی باتری ۵⁃ ۶ ولت به عنوان منبع خارج استفاده م کنیم.

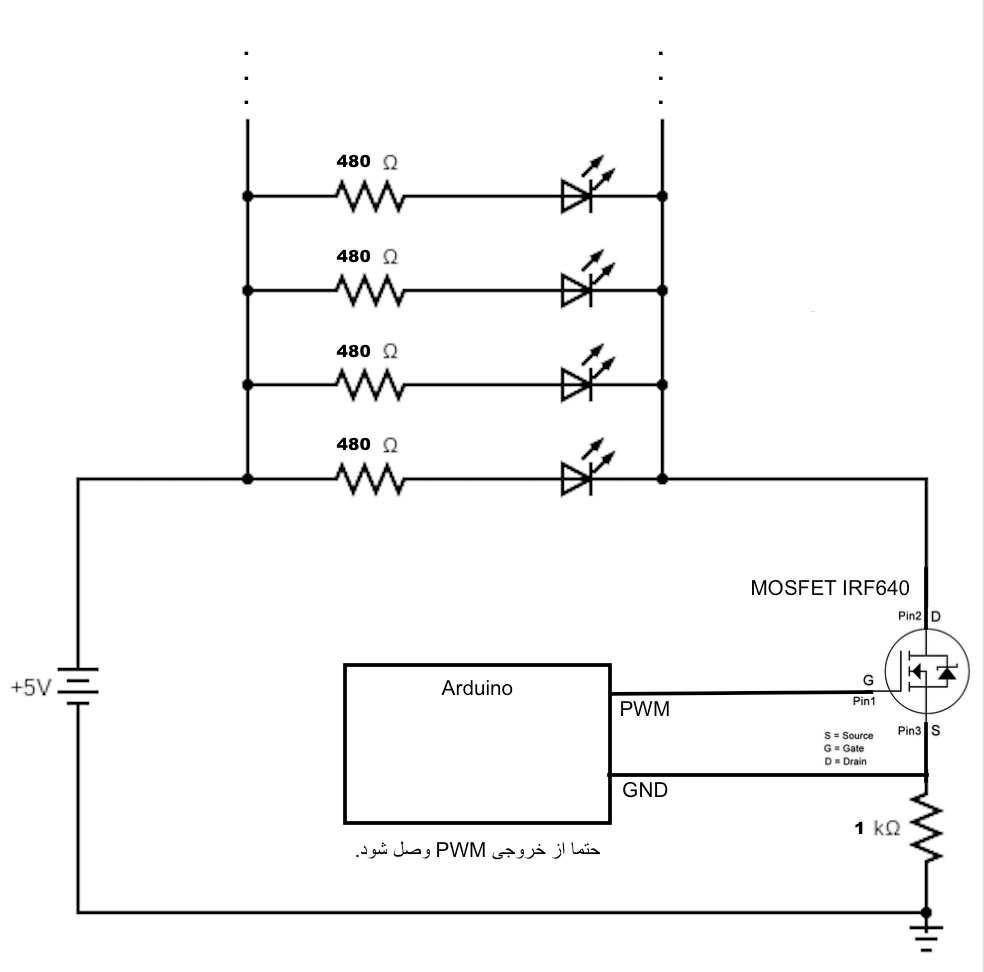
[picture p29: figure]

شل :۱ شماتی مدار

در این مدار، LED ها به باتری وصل هستند و خروج PWM به گیت کنترل ترانزیستور 640IRF MOSFET متصل است. م دانیم که PWM به کم روشن و خاموش کردن سریع م تواند روشنایی را کنترل کند. در اینجا، بجای اتصال مستقیم PWM به LED ها، به گیت ترانزیستور متصل شده و آن را به سرعت قطع و وصل م کند. یعن ترانزیستوری میان باتری و LED است که سرعت قطع و وصل کردن آن با PWM تنظیم م شود.

۲

در شل های زیر م توان مدار بسته شده و نتیجه تغییر روشنایی LED ها بخاطر تغییر روشنایی دریافت سنسور را مشاهده کرد.

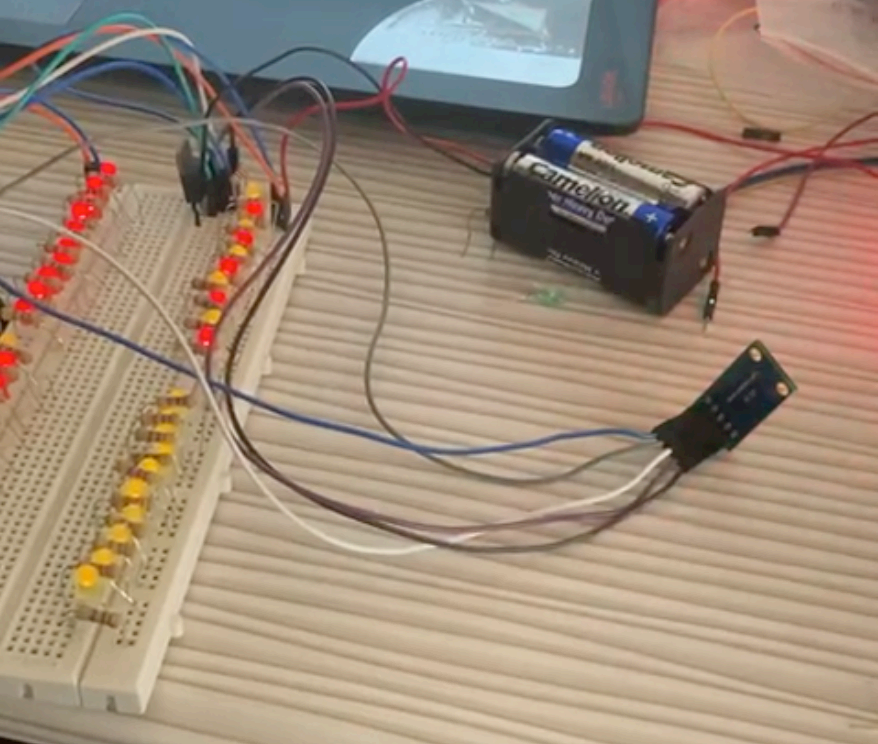
[picture p30: figure]

شل :۲ مدار لوستر قبل از انداختن نور بر روی سنسور روشنایی

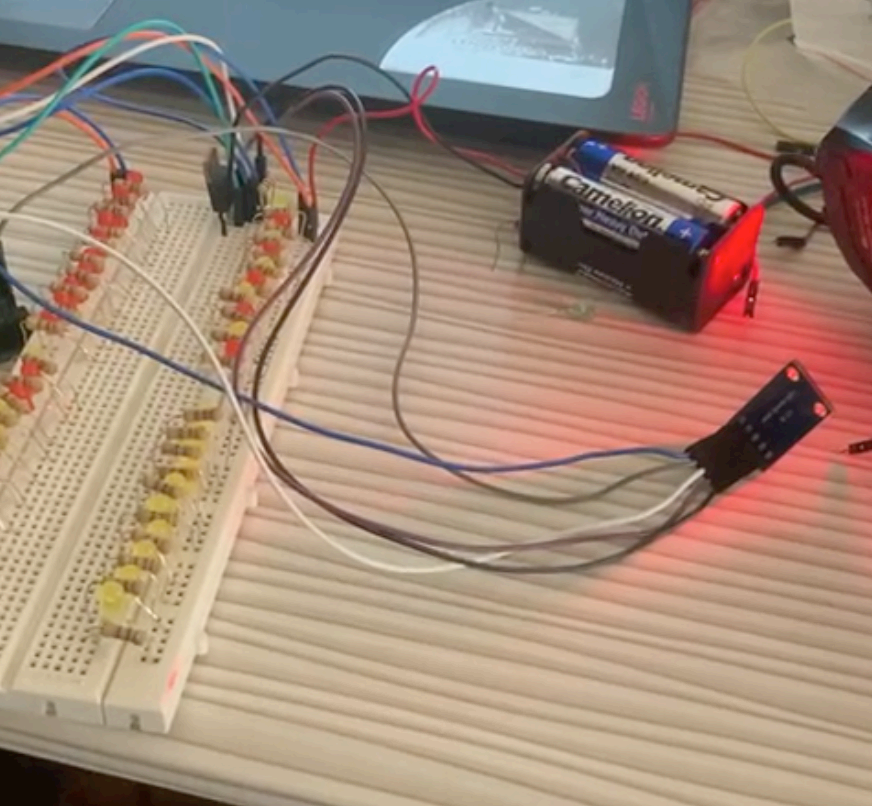
[picture p31: figure]

شل :۳ مدار لوستر بعد از انداختن نور بر روی سنسور روشنایی. مشاهده م کنیم که نور LED ها کاهش م یابد.

۳

در ادامه نیز م توان کد استفاده شده برای این قسمت را مشاهده کرد. تغییرات اندک در کد برای تنظیم دقیق تر و هماهنگ تر کردن بازه تغییرات روشنایی با نور اتاق است. اکثر تغییرات اعمال شده در گزارش این هفته به صورت پیاده سازی سخت افزاری بوده است.

#include <Wire.h>

#include <BH1750.h>

BH1750 lightMeter;
const int lowestPin = 2;

const int highestPin = 7;

void setup() {
Serial.begin(9600);
Wire.begin();
lightMeter.begin();

// set pins 2 through 7 as outputs:
for (int thisPin = lowestPin; thisPin <= highestPin; thisPin++) {
pinMode(thisPin , OUTPUT);

}

}

void loop() {
float lux = min(1, lightMeter.readLightLevel() / 75);
24 | float inv_lux = | (1 - lux);
int brightness = inv_lux * 255;
| Serial.print(lux); Serial.print(" ");

Serial.println(inv_lux);
// iterate over the pins:
for (int thisPin = lowestPin; thisPin <= highestPin;
| thisPin++) {
analogWrite(thisPin , brightness);
| } delay(200);

}

۴
