Sharif-University-ESRLab/project-team-5/Document/Final Report/latex/figs/irf640-pinout.gif

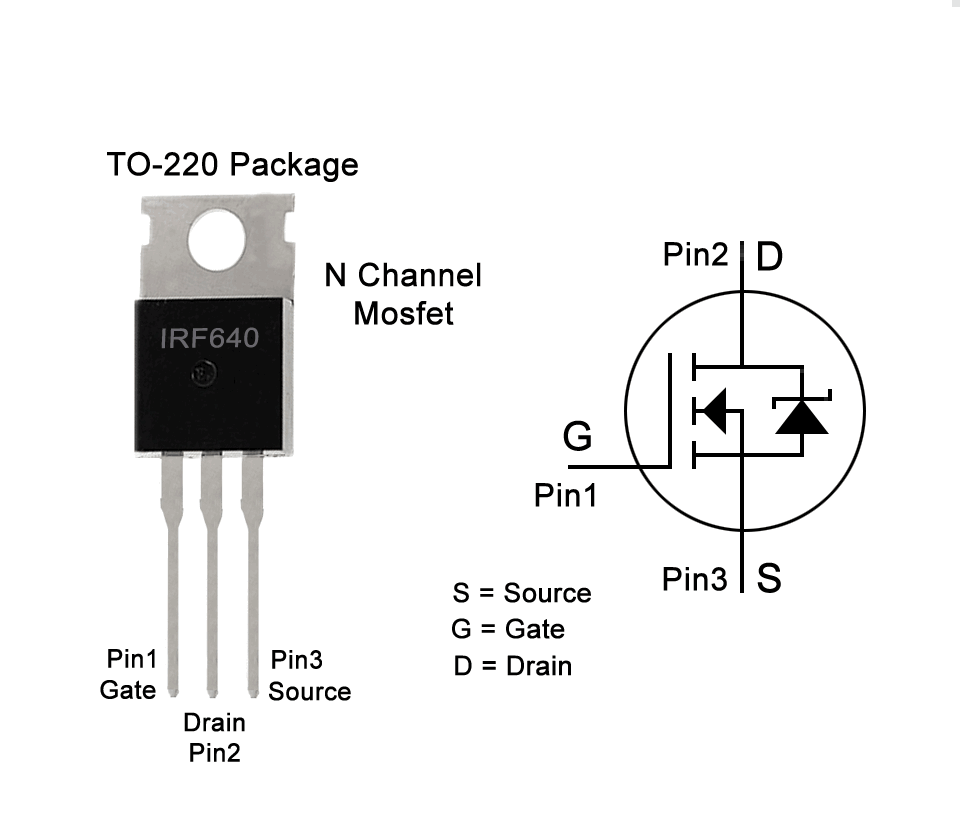
Document/Final Report/latex/figs/irf640-pinout.gif
