Sharif-University-ESRLab/project-team-5/Document/Week 1/latex/src/Serial/Serial.ino

const int lowestPin = 2;

const int highestPin = 7;

void setup() {

  // set pins 2 through 7 as outputs:

  for (int thisPin = lowestPin; thisPin <= highestPin;
    thisPin++) {

    pinMode(thisPin, OUTPUT);

  }
}

void loop() {

  /*
  for (int thisPin = lowestPin; thisPin <= highestPin;
    thisPin++) {
    analogWrite(thisPin,255);
  }
  */
  // iterate over the pins:
  for (int thisPin = lowestPin; thisPin <= highestPin;
    thisPin++) {

    // fade the LED on thisPin from off to brightest:

    for (int brightness = 0; brightness < 255;
      brightness++) {

      analogWrite(thisPin, brightness);

      delay(2);

    }

    // fade the LED on thisPin from brightest to off:
    for (int brightness = 255; brightness >= 0; 
      brightness--) {

      analogWrite(thisPin, brightness);

      delay(2);

    }

    // pause between LEDs:
    delay(100);

  }
}
